ayur1311/Enthalyzer/CAD FIles/ESP Holder Plate.DXF

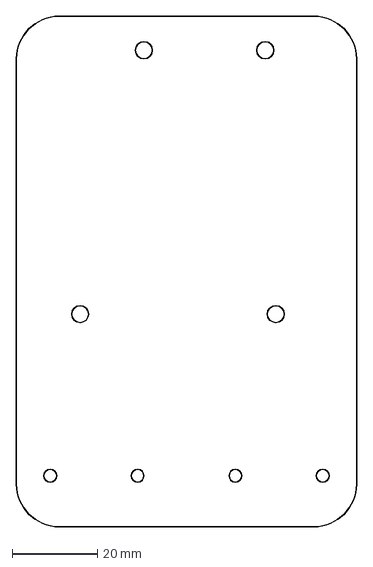
[picture p1: CAD file, 2026-11-05]
CAD FIles/ESP Holder Plate.DXF
80.0 x 120.0 mm
