ayur1311/Enthalyzer/CAD FIles/Condenser Top Plate.STL

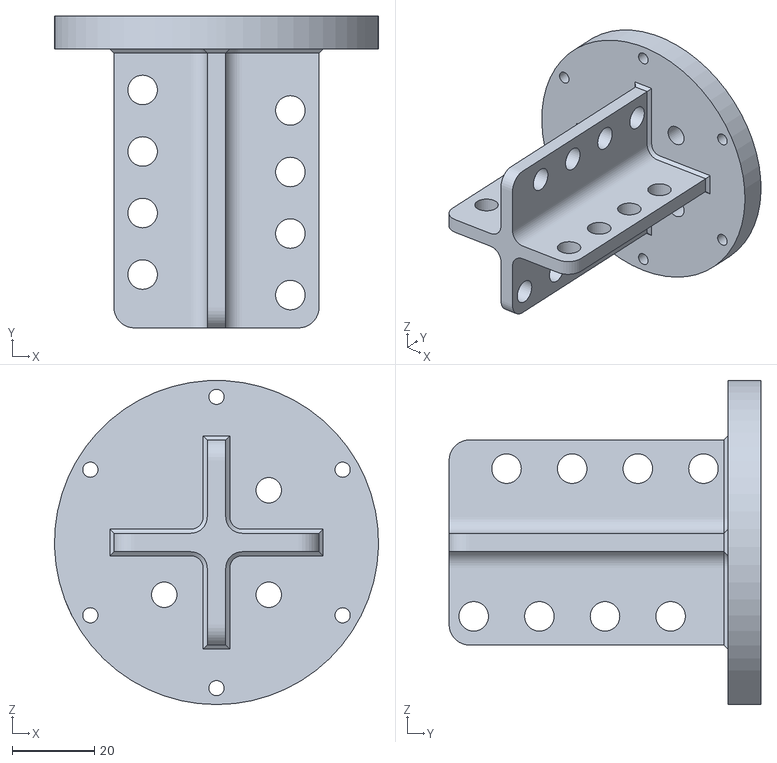
[picture p2: CAD file, 2026-11-05]
CAD FIles/Condenser Top Plate.STL
79.0 x 76.0 x 79.0
