ayur1311/Enthalyzer/CAD FIles/Temperature Calibration Adapter_PT100.STL

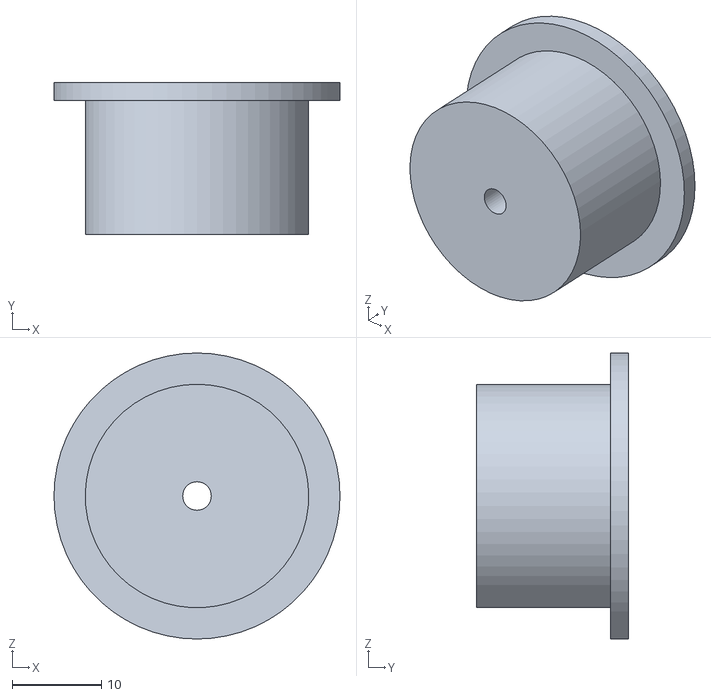
[picture p3: CAD file, 2026-11-05]
CAD FIles/Temperature Calibration Adapter_PT100.STL
32.0 x 17.0 x 32.0
