ayur1311/Enthalyzer/CAD FIles/Temperature Calibration Adapter_SHT45.STL

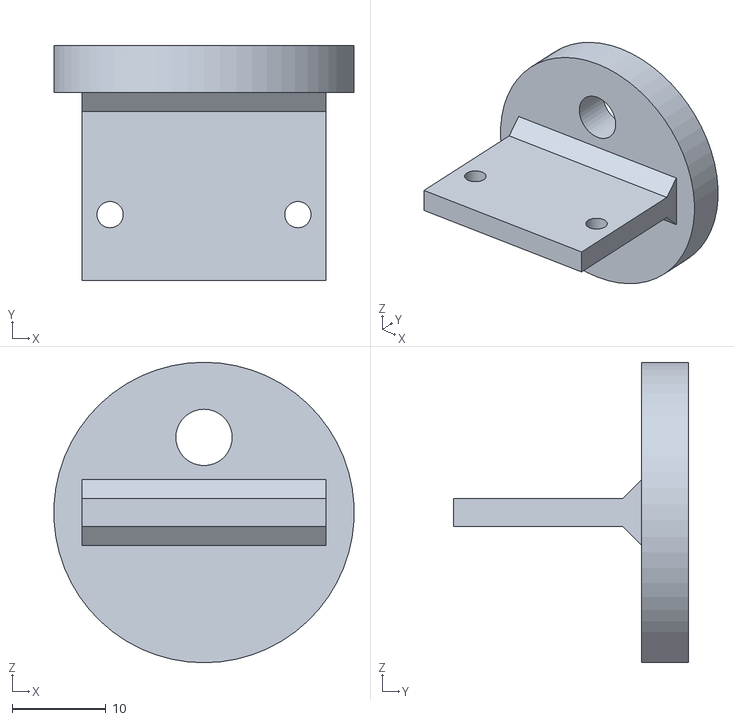
[picture p4: CAD file, 2026-11-05]
CAD FIles/Temperature Calibration Adapter_SHT45.STL
32.0 x 25.0 x 32.0
