ayur1311/Enthalyzer/CAD FIles/Condenser_Adapter.STL

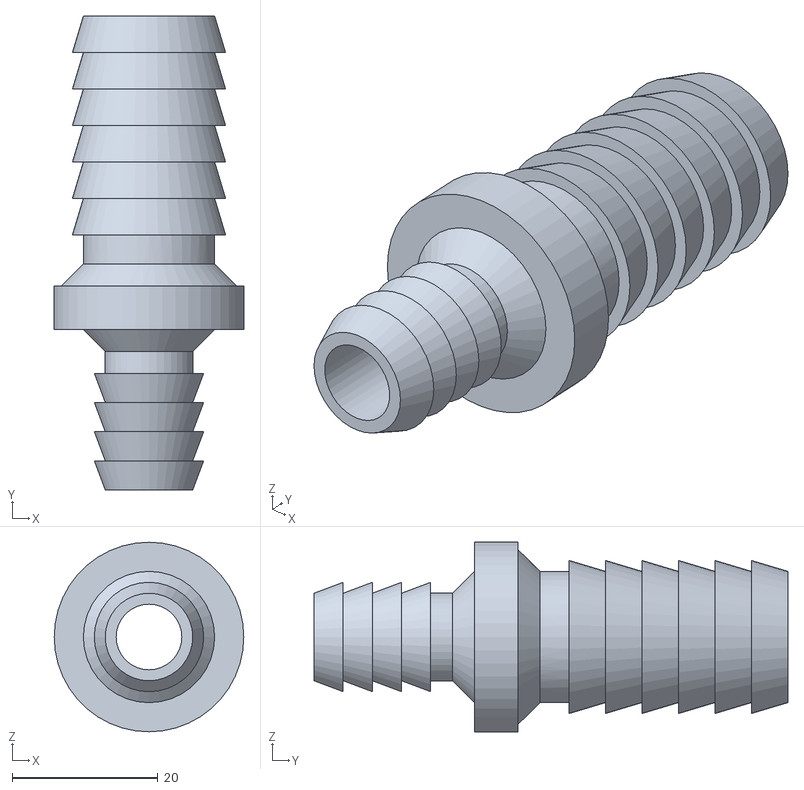
[picture p5: CAD file, 2026-11-05]
CAD FIles/Condenser_Adapter.STL
26.0 x 65.0 x 26.0
