ayur1311/Enthalyzer/CAD FIles/SHT 45 Sensor Holder.STL

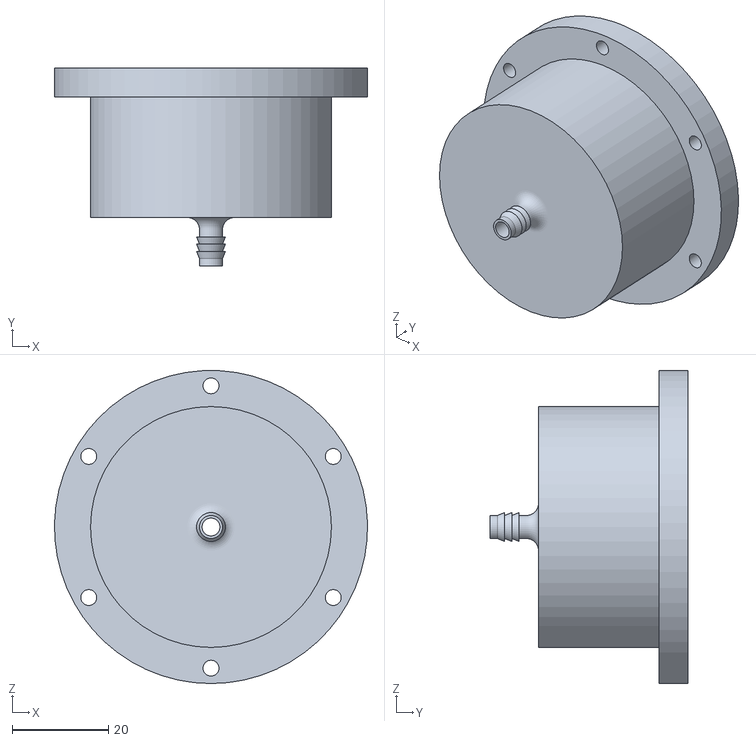
[picture p6: CAD file, 2026-11-05]
CAD FIles/SHT 45 Sensor Holder.STL
65.0 x 41.0 x 65.0
