ayur1311/Enthalyzer/CAD FIles/Condenser Vessel.STL

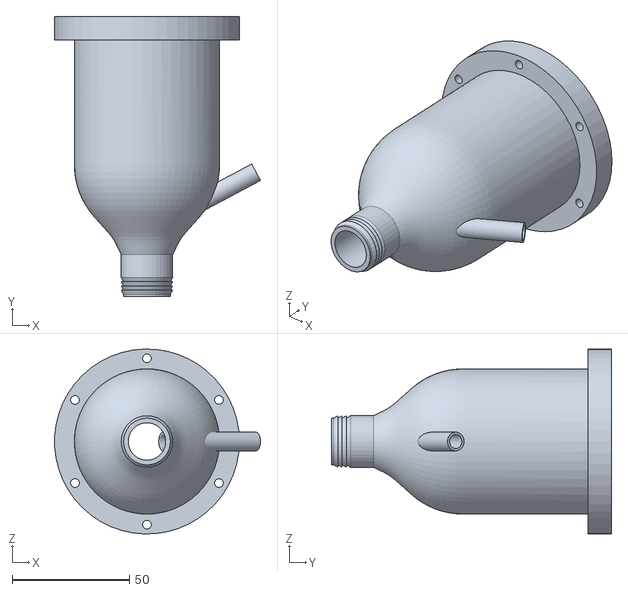
[picture p7: CAD file, 2026-11-05]
CAD FIles/Condenser Vessel.STL
88.0 x 119.7 x 79.0
