ayur1311/Enthalyzer/CAD FIles/Sensor Holder Top Plate.STL

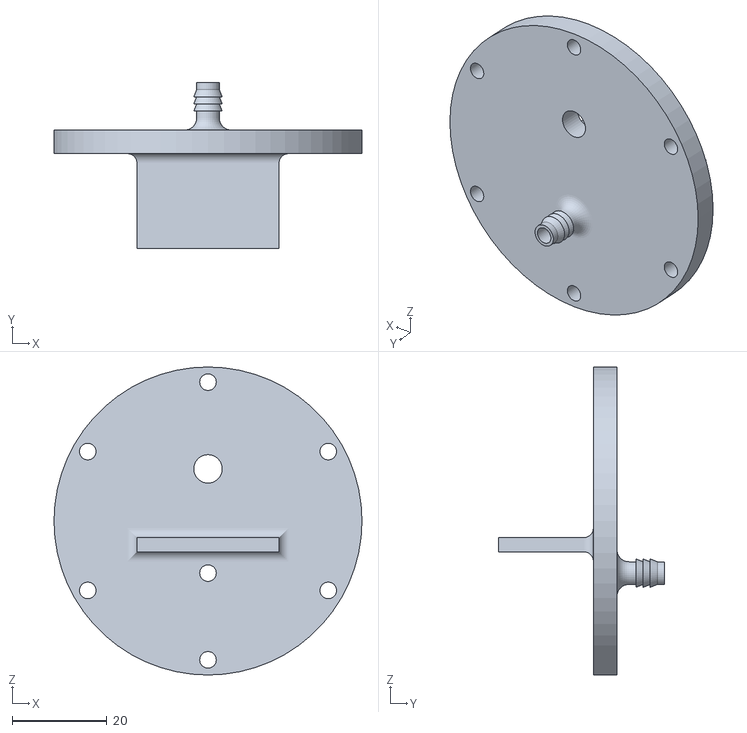
[picture p8: CAD file, 2026-11-05]
CAD FIles/Sensor Holder Top Plate.STL
65.0 x 35.0 x 65.0
