ayur1311/Enthalyzer/(commit log)

2026-11-05 Updated README with detailed project description
    Expanded project description to include details about the condenser design, sensor setup, and monitoring capabilities.
2026-11-05 Create STL Files
